finnglink/mittzon-esphome/hardware/box.stl

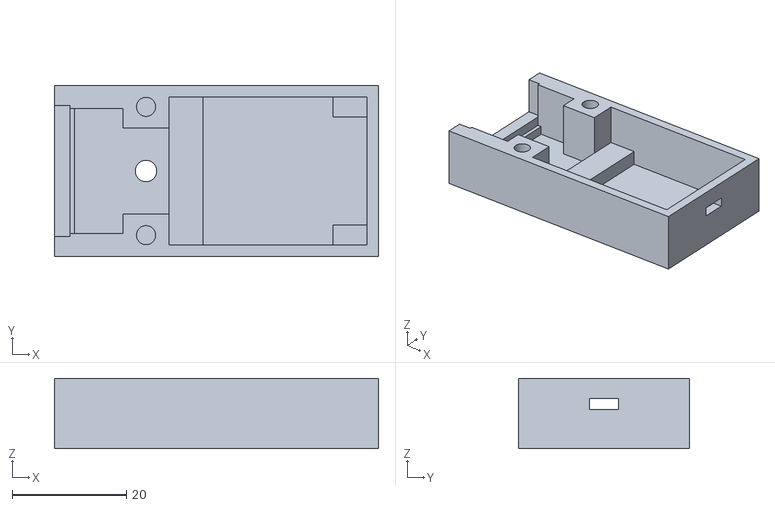
[picture p10: CAD file, 2026-10-14]
hardware/box.stl
56.8 x 30.0 x 12.4
