finnglink/mittzon-esphome/hardware/lid.stl

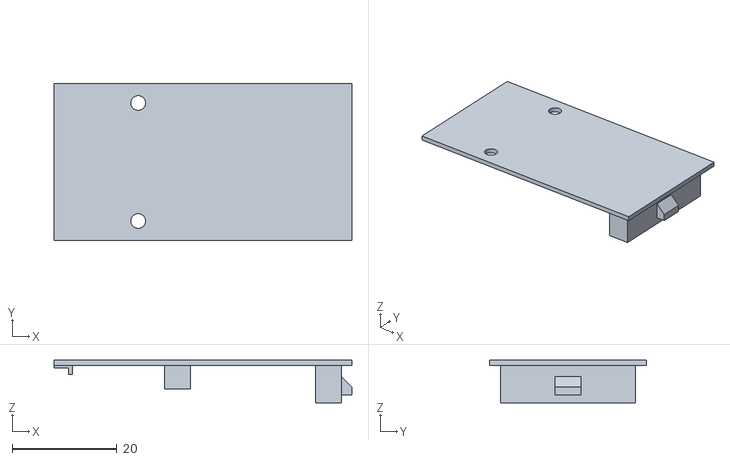
[picture p11: CAD file, 2026-10-14]
hardware/lid.stl
56.8 x 30.0 x 8.15
